furrysalamander/Pi-A3-Game-Console/README.md

# Pi-A3-Game-Console

The firmware for the microcontroller that handles the inputs is in the controller folder.
