furrysalamander/Pi-A3-Game-Console/Pi-A3-Game-Console/Game-Console-Finish-Schematic.pdf

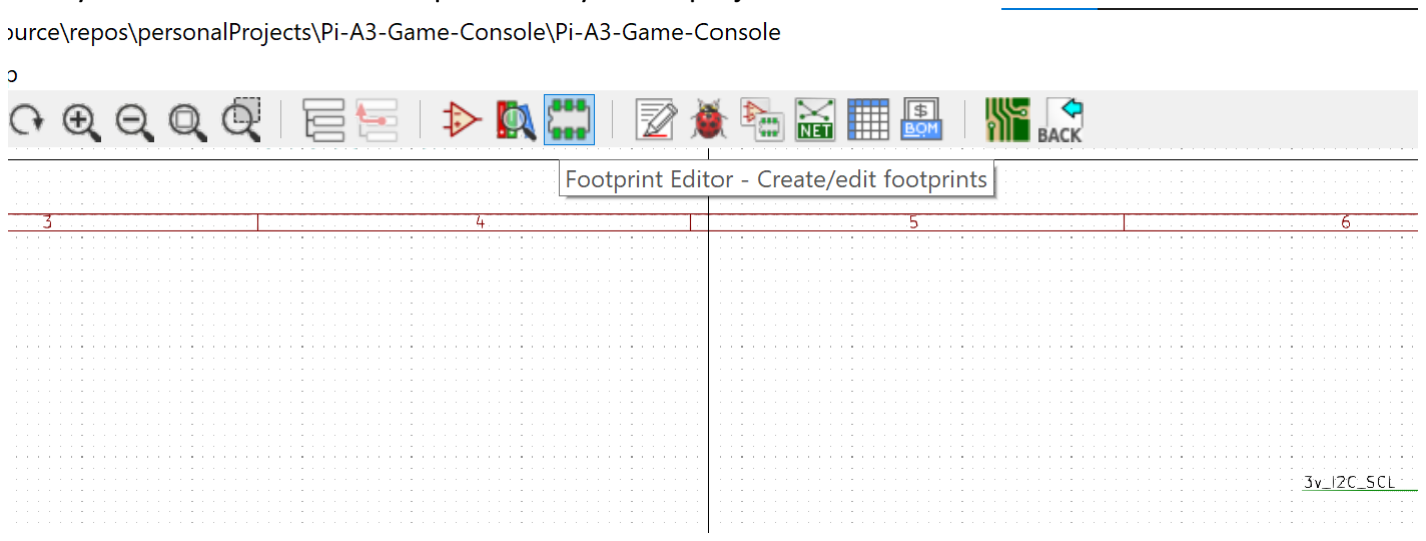
[picture p1: figure]

First you’ll need to add the footprint library to the project

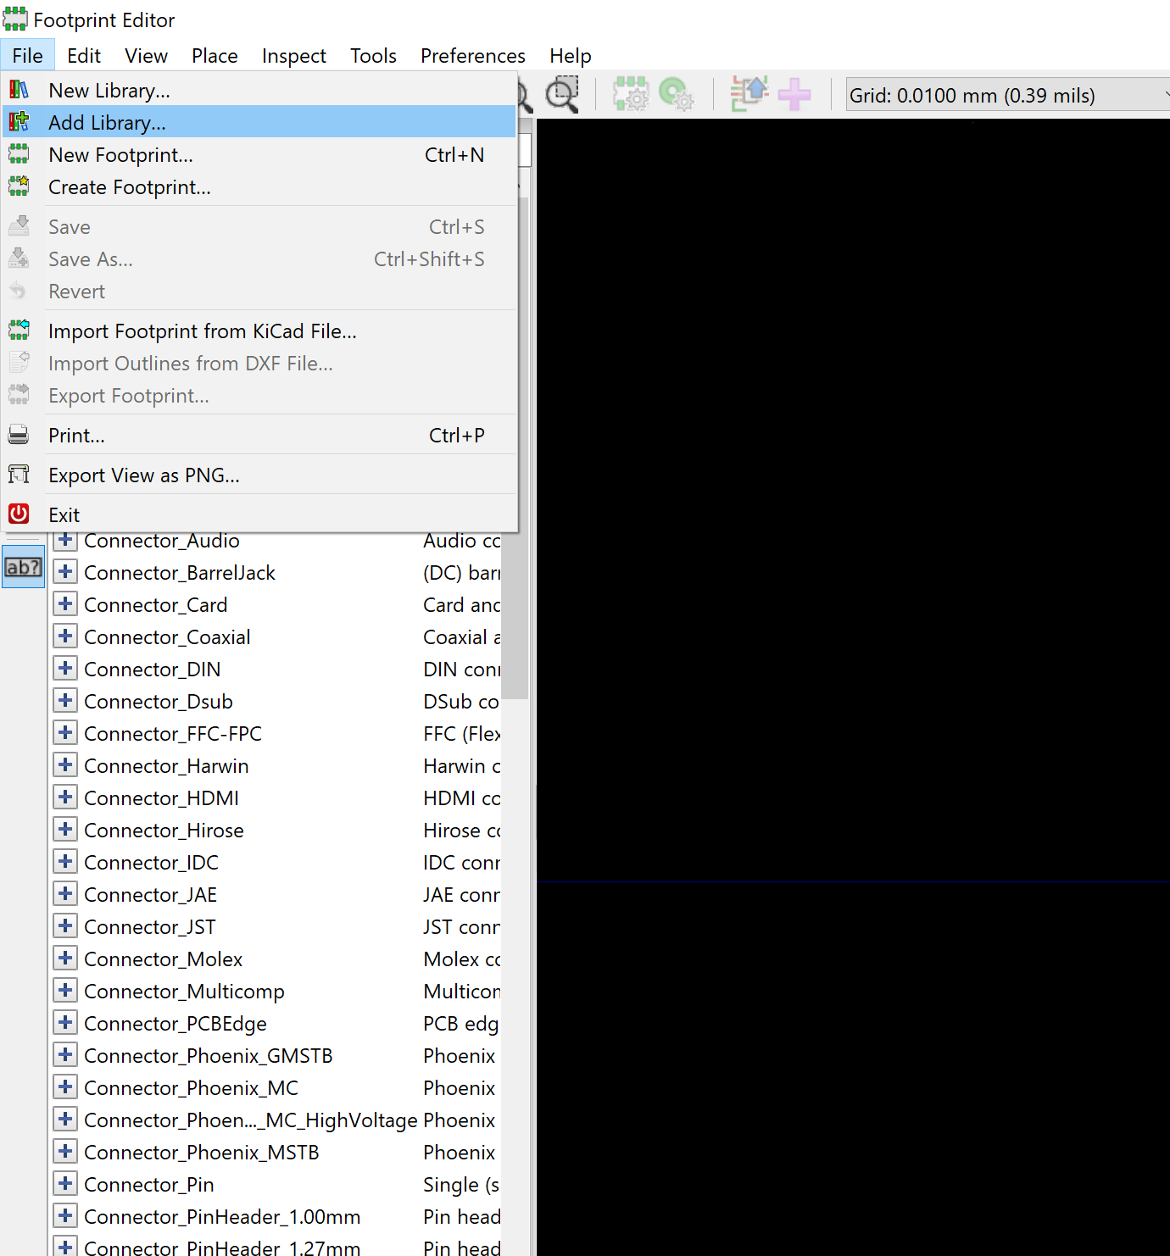
[picture p2: figure]
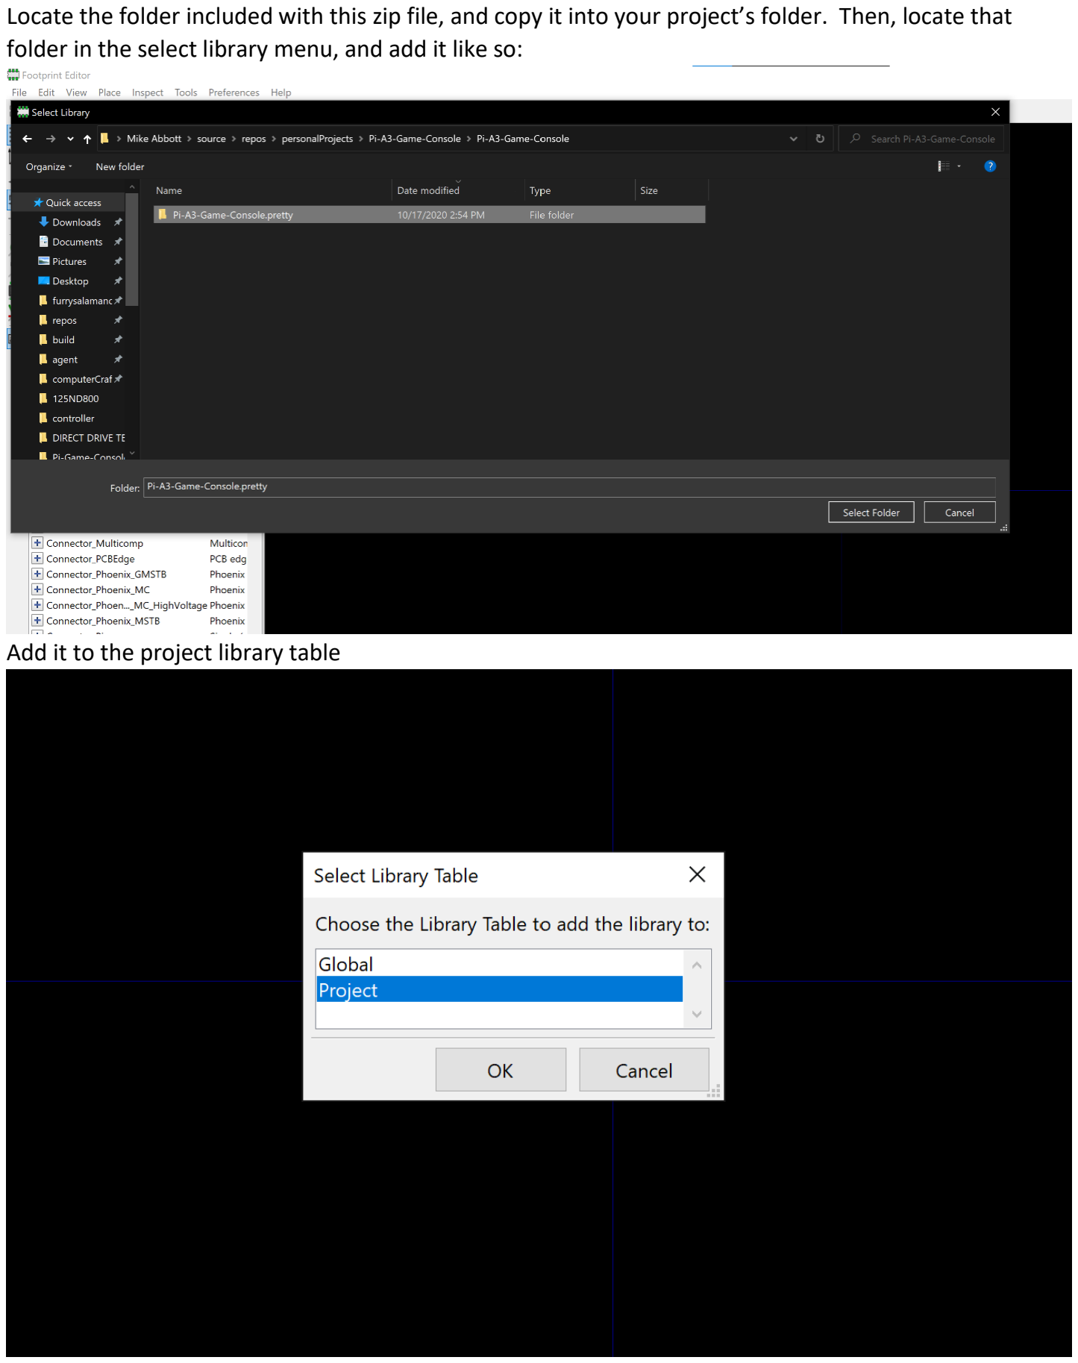
[picture p3: page 3]

Locate the folder included with this zip file, and copy it into your project’s folder. Then, locate that folder in the select library menu, and add it like so:

Add it to the project library table

Verify that it was successfully added by searching for it in the footprint editor. If it’s there, you can close this window and proceed to the next step.

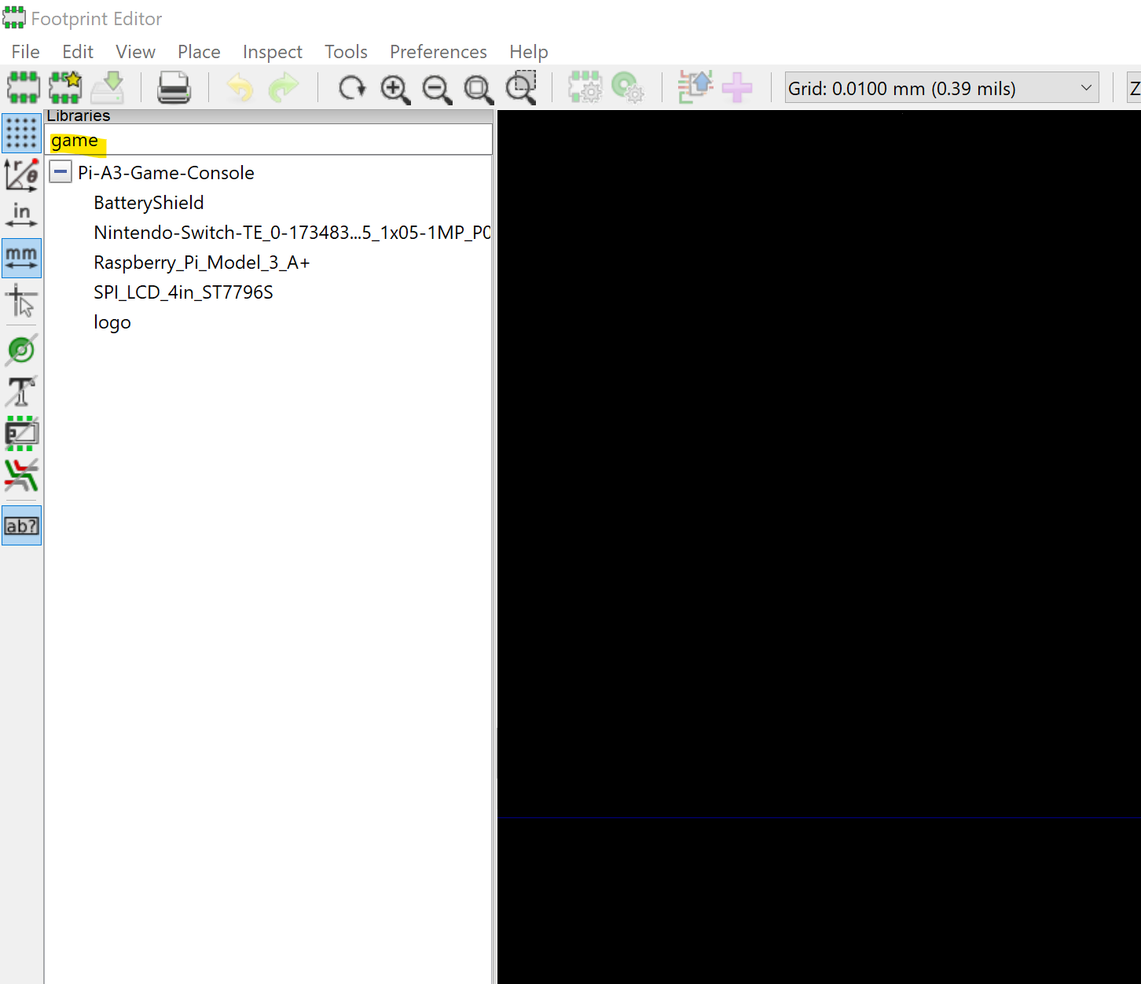
[picture p4: figure]

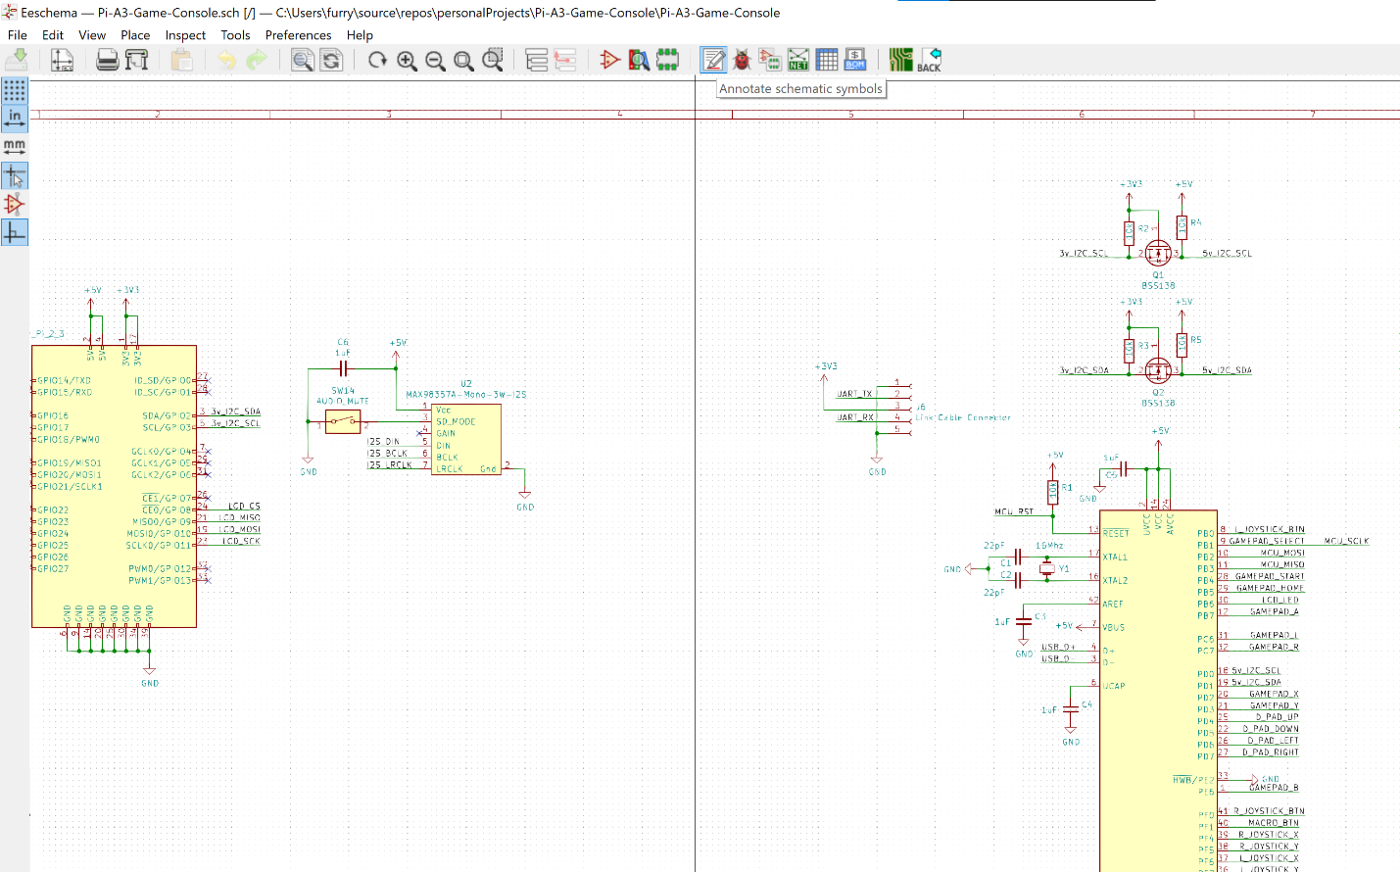
[picture p5: figure]

Next you’ll need to assign part numbers to each component. Do this using this button.

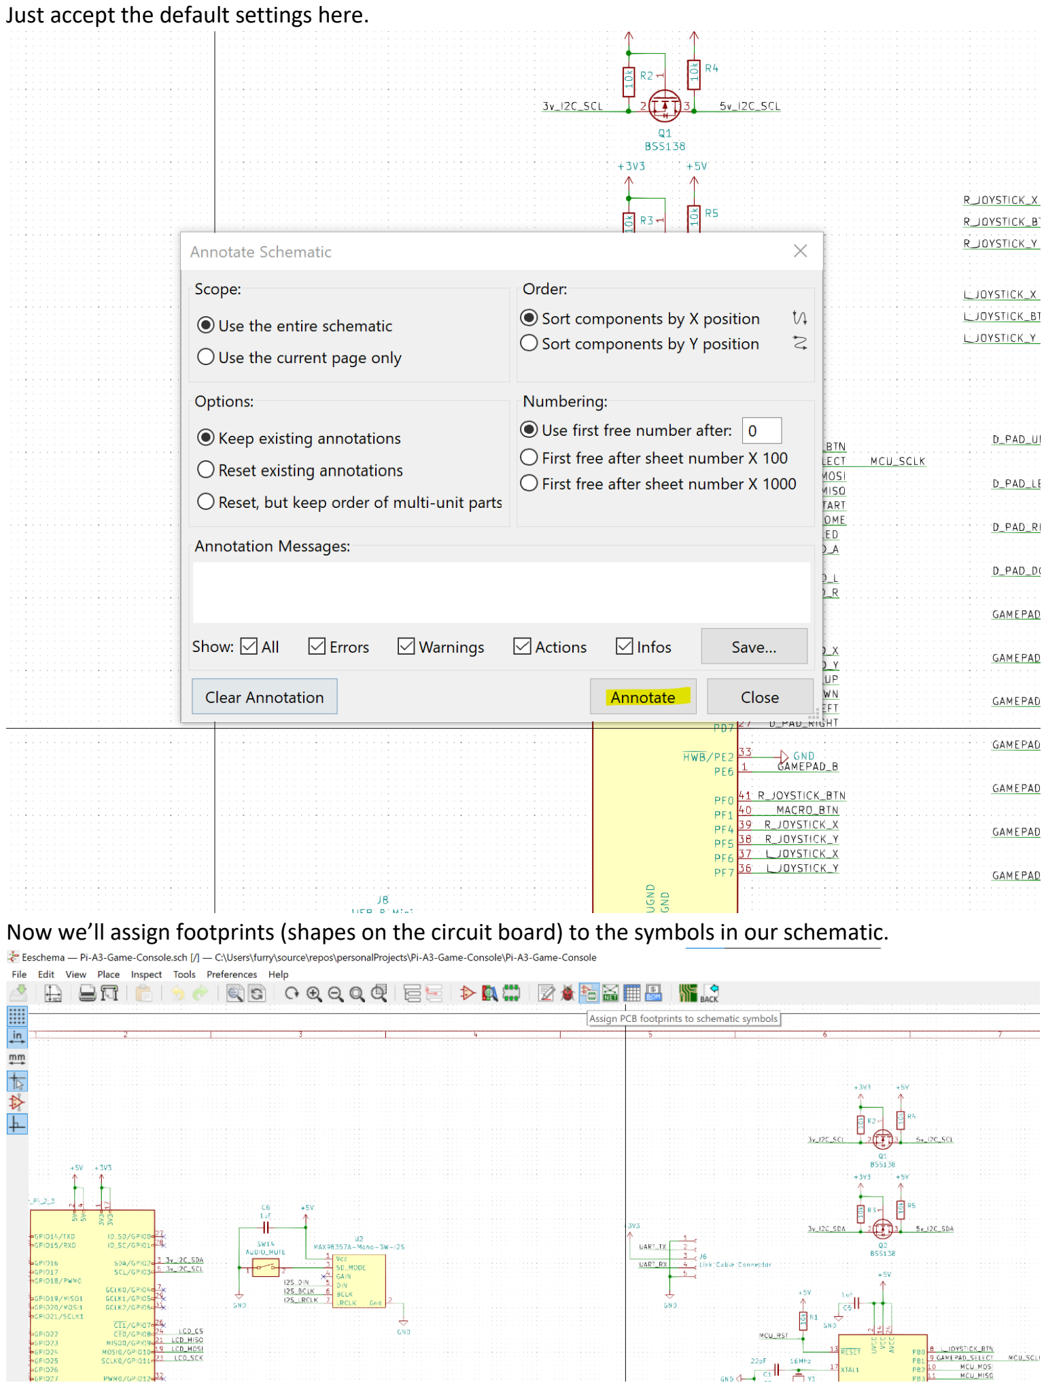
[picture p6: page 6]

Just accept the default settings here.

Now we’ll assign footprints (shapes on the circuit board) to the symbols in our schematic.

This part is a little tricky, so I’m going to suggest the easiest way to do it. First, select the top
component. Then, uncheck all three of those boxes on the left hand side of label 2. This may cause your computer to lag for a second. Then make sure the box right next to the search bar is checked. Then you can just search for the footprint names. Once you’ve found the matching footprint, go ahead and double click it over on the right side. That will assign that footprint to that symbol. Go through and assign footprints to each schematic symbol. You’ll need to match them based on the value of each part, IE, 22pF, and *NOT* the symbol number (IE, C1) because it may be different on your project.

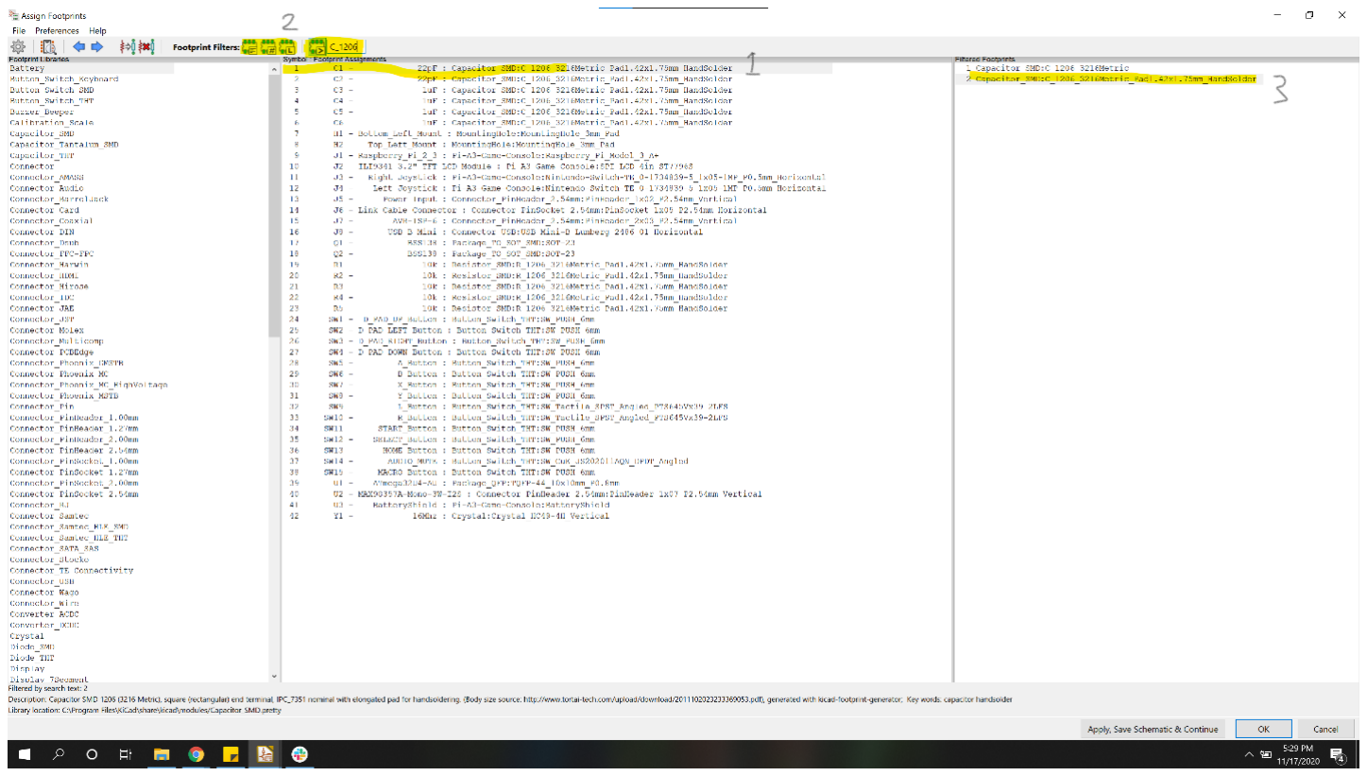
[picture p7: figure]
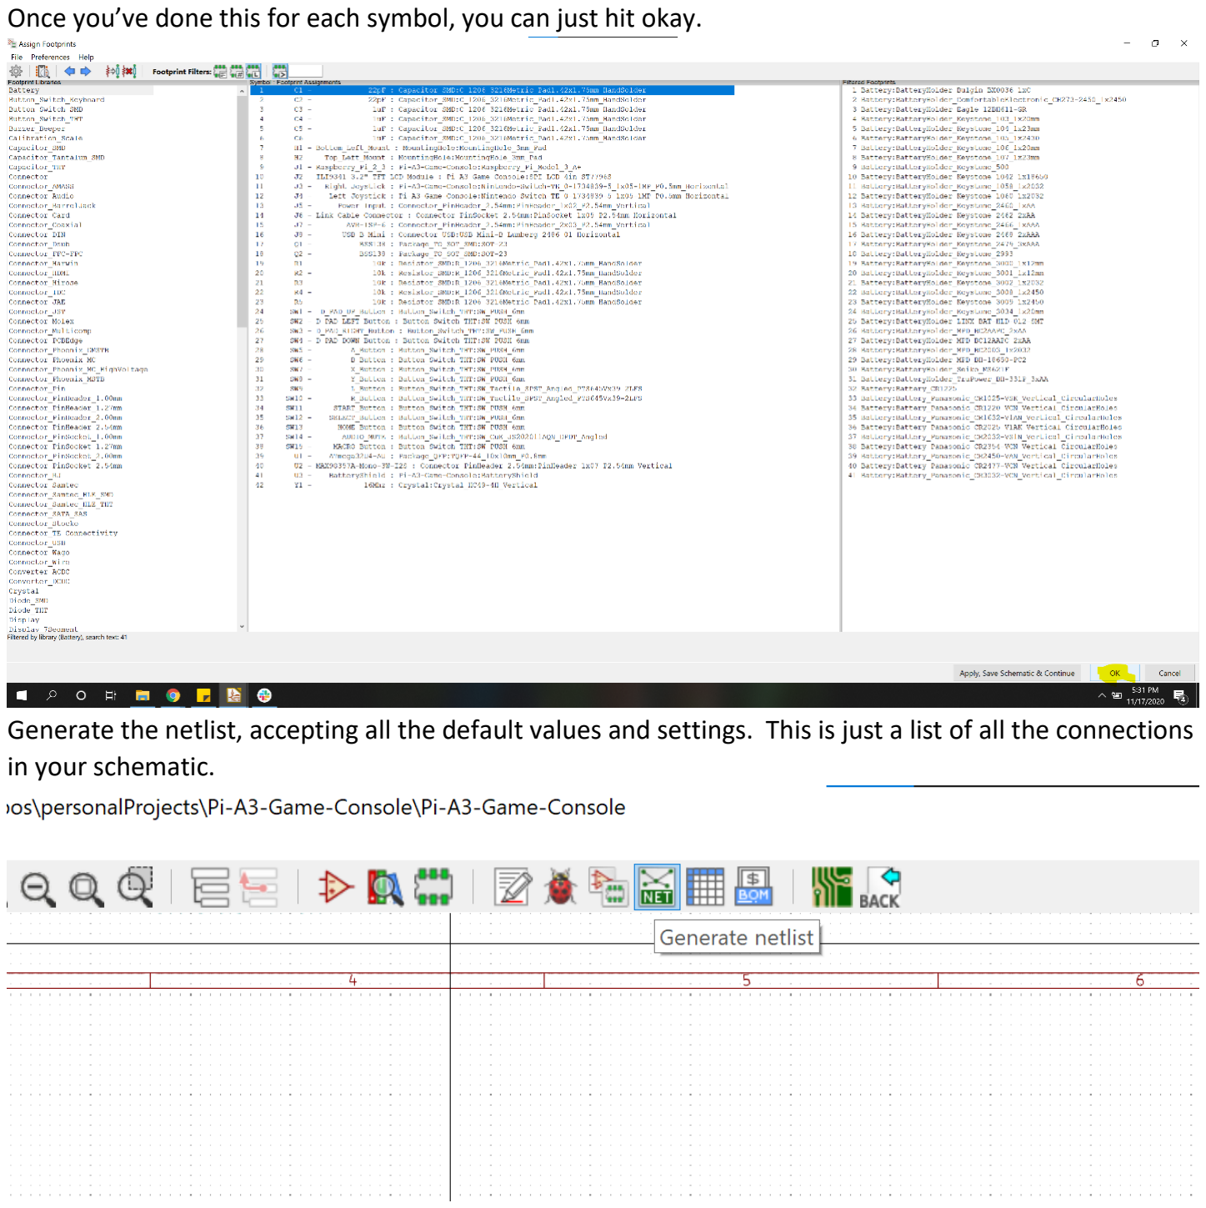
[picture p8: page 8]

Once you’ve done this for each symbol, you can just hit okay.

Generate the netlist, accepting all the default values and settings. This is just a list of all the connections in your schematic.

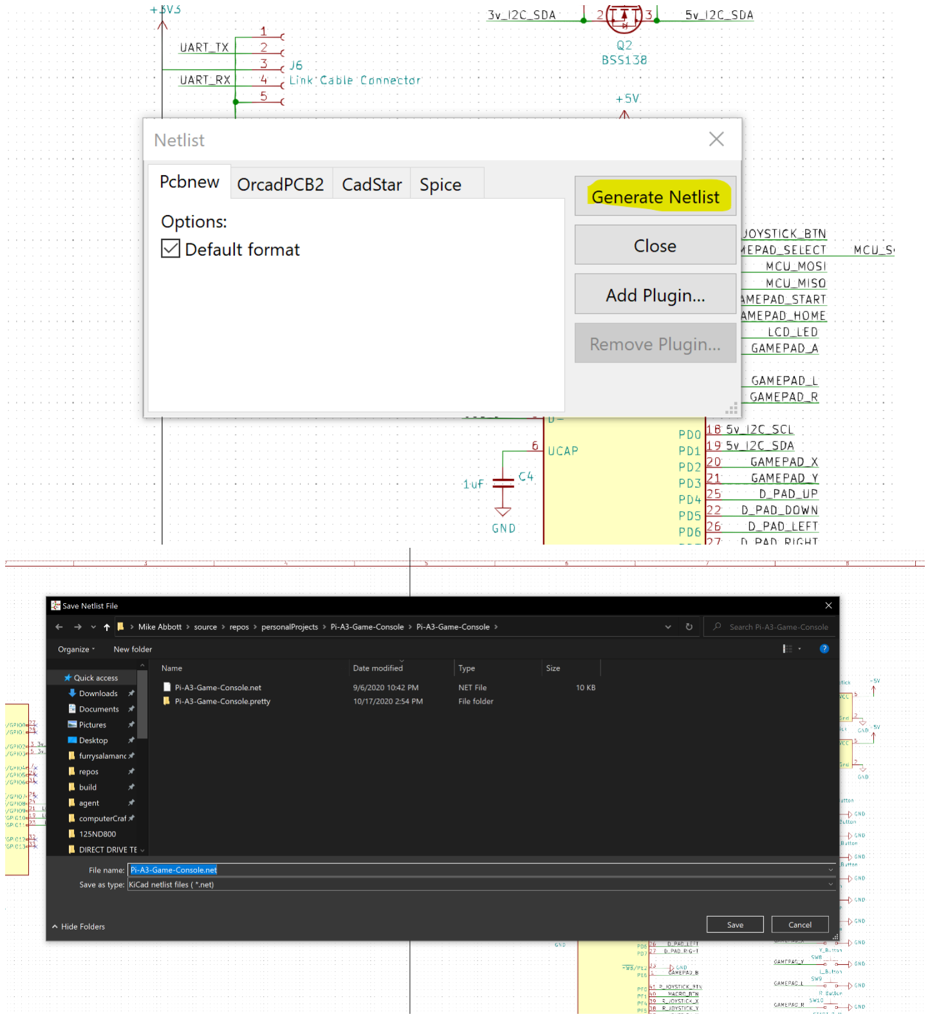
[picture p9: figure]
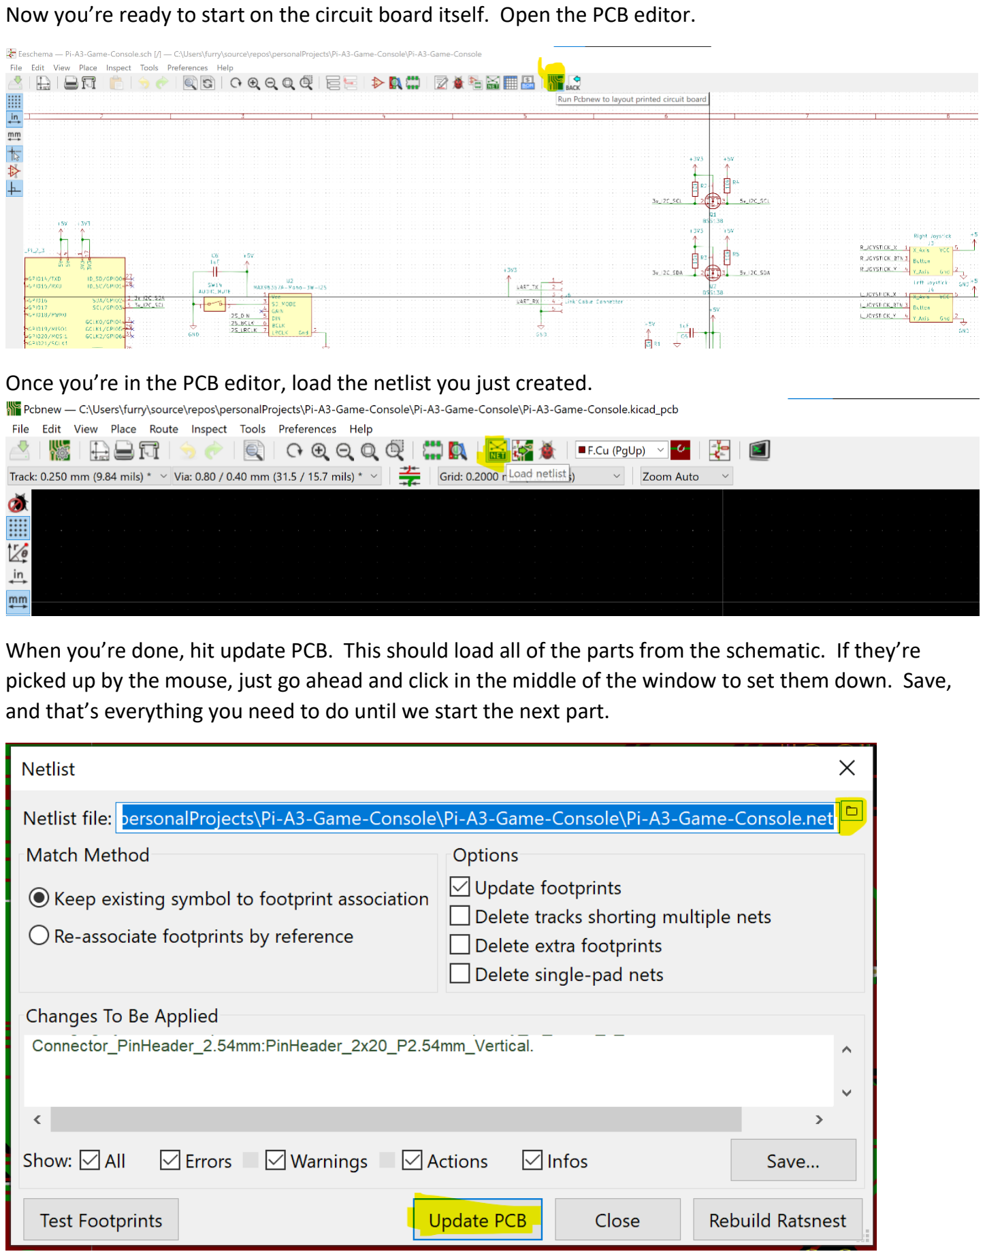
[picture p10: page 10]

Now you’re ready to start on the circuit board itself. Open the PCB editor.

Once you’re in the PCB editor, load the netlist you just created.

When you’re done, hit update PCB. This should load all of the parts from the schematic. If they’re picked up by the mouse, just go ahead and click in the middle of the window to set them down. Save, and that’s everything you need to do until we start the next part.
