furrysalamander/Pi-A3-Game-Console/GameConsoleCase/Small Button.stl

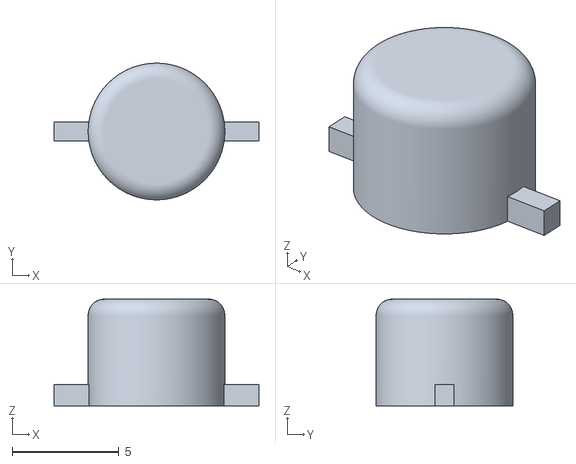
[picture p11: CAD file, 2021-10-13]
GameConsoleCase/Small Button.stl
9.60 x 6.40 x 5.00
