furrysalamander/Pi-A3-Game-Console/Pi-A3-Game-Console/4-LCD-Rough-v2.step

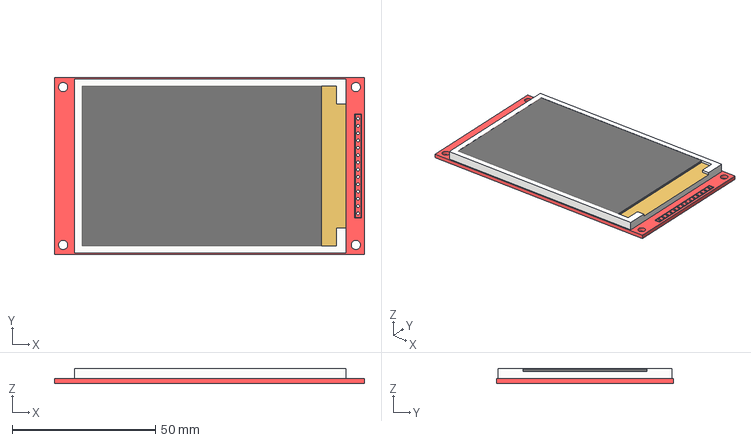
[picture p12: CAD file, 2020-10-09]
Pi-A3-Game-Console/4-LCD-Rough-v2.step
108.0 x 61.7 x 5.10 mm
