furrysalamander/Pi-A3-Game-Console/GameConsoleCase/Battery Panel.stl

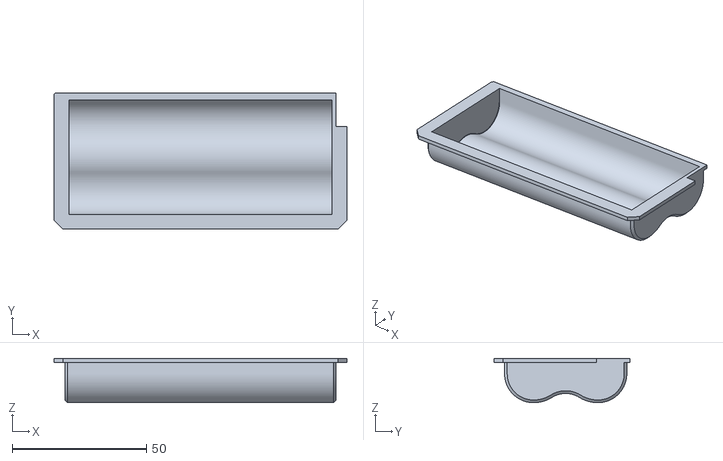
[picture p13: CAD file, 2021-10-13]
GameConsoleCase/Battery Panel.stl
109.0 x 50.8 x 16.5
