furrysalamander/Pi-A3-Game-Console/Pi-A3-Game-Console/Battery Shield.step

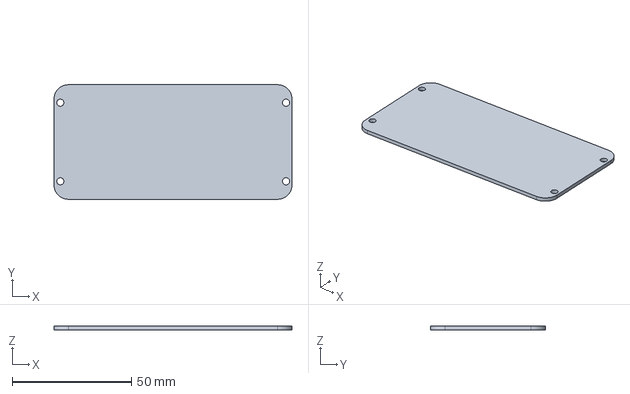
[picture p14: CAD file, 2020-10-09]
Pi-A3-Game-Console/Battery Shield.step
100.0 x 48.1 x 1.60 mm
