furrysalamander/Pi-A3-Game-Console/GameConsoleCase/Rear Panel.stl

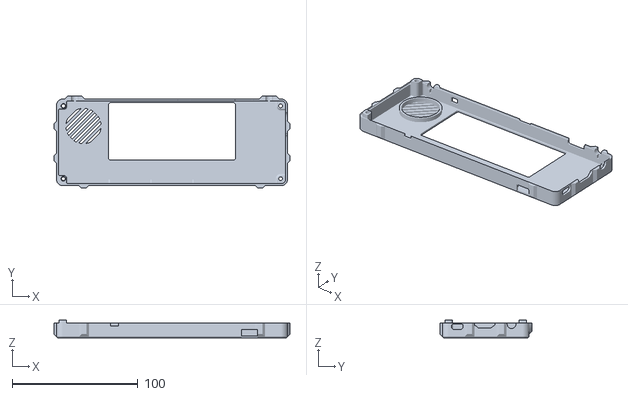
[picture p15: CAD file, 2021-10-13]
GameConsoleCase/Rear Panel.stl
188.0 x 73.5 x 14.3
