furrysalamander/Pi-A3-Game-Console/Pi-A3-Game-Console/LCD_Rough.dxf

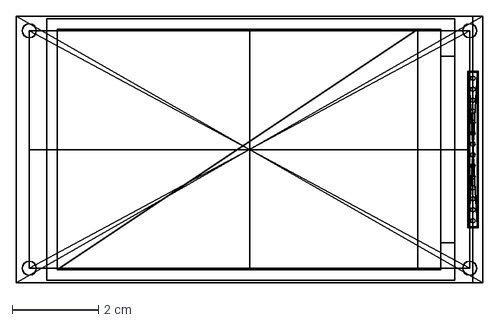
[picture p16: CAD file, 2020-10-09]
Pi-A3-Game-Console/LCD_Rough.dxf
10.8 x 6.17 cm
