furrysalamander/Pi-A3-Game-Console/GameConsoleCase/dpad.stl

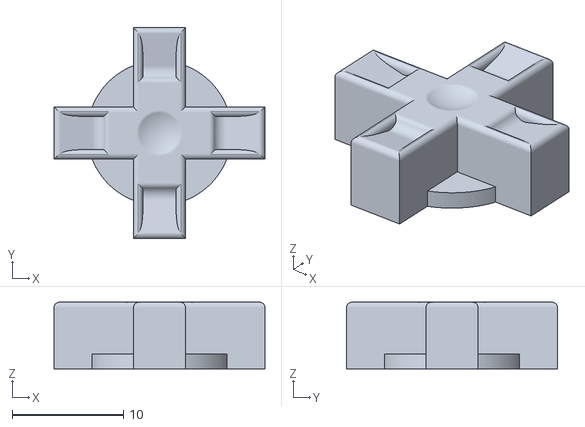
[picture p17: CAD file, 2021-10-13]
GameConsoleCase/dpad.stl
19.0 x 19.0 x 6.00
