furrysalamander/Pi-A3-Game-Console/GameConsoleCase/Front Panel.stl

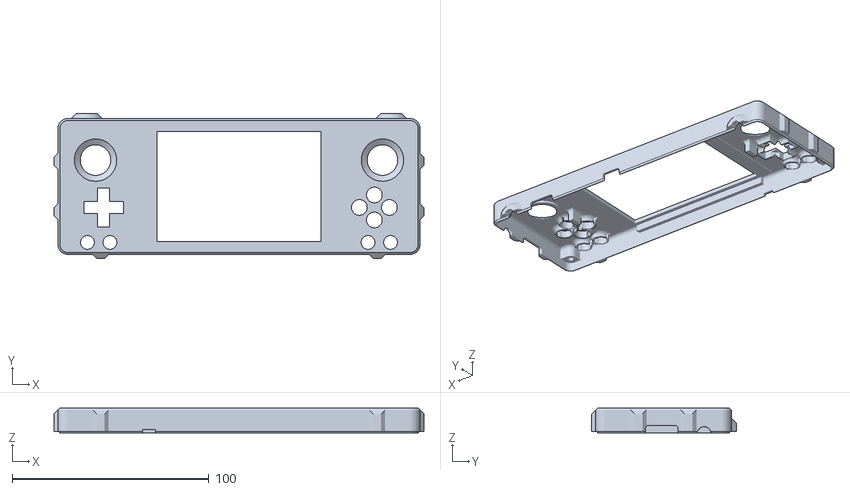
[picture p18: CAD file, 2021-10-13]
GameConsoleCase/Front Panel.stl
188.0 x 73.5 x 12.7
