furrysalamander/Pi-A3-Game-Console/Pi-A3-Game-Console/Pi-A-Mechanical.dxf

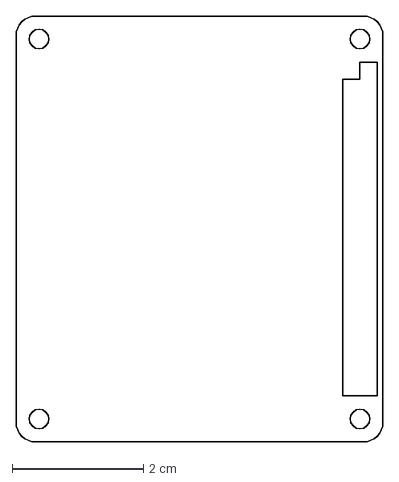
[picture p19: CAD file, 2020-09-22]
Pi-A3-Game-Console/Pi-A-Mechanical.dxf
5.60 x 6.50 cm
