furrysalamander/Pi-A3-Game-Console/GameConsoleCase/Button.stl

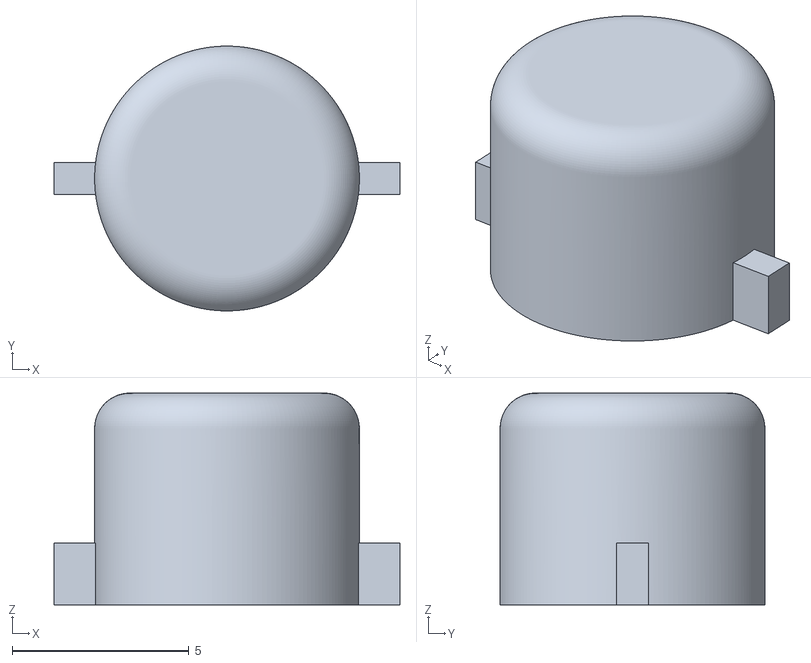
[picture p20: CAD file, 2021-10-13]
GameConsoleCase/Button.stl
9.80 x 7.50 x 6.00
