furrysalamander/Pi-A3-Game-Console/Pi-A3-Game-Console/switch_joystick.step

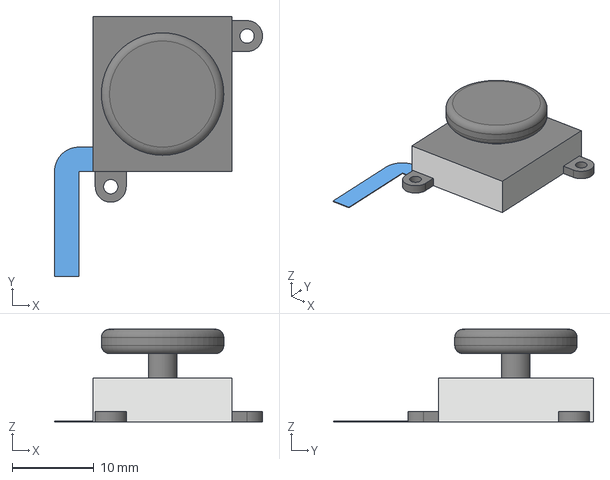
[picture p21: CAD file, 2020-09-22]
Pi-A3-Game-Console/switch_joystick.step
25.5 x 31.9 x 11.3 mm
