furrysalamander/Pi-A3-Game-Console/GameConsoleCase/Shoulder Button.stl

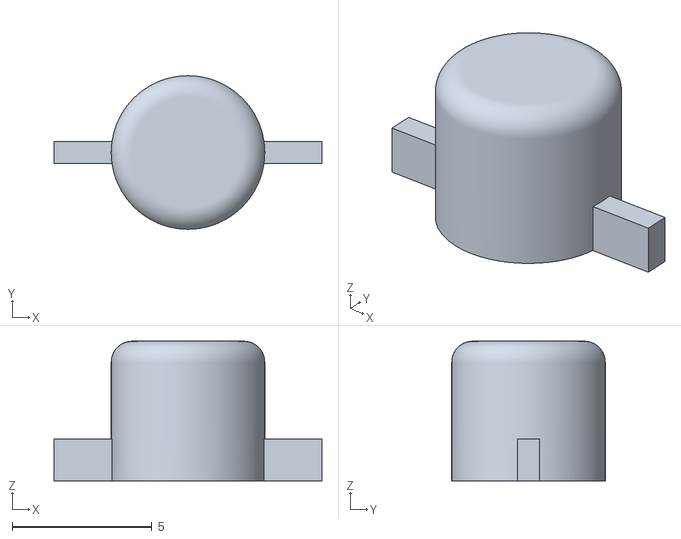
[picture p22: CAD file, 2021-10-13]
GameConsoleCase/Shoulder Button.stl
9.60 x 5.50 x 5.00
