furrysalamander/Pi-A3-Game-Console/Pi-A3-Game-Console/ssfv5r_4stlf.stp

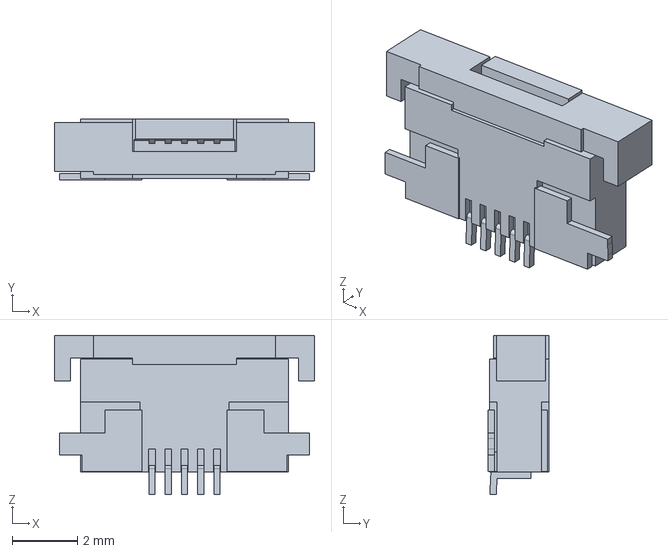
[picture p23: CAD file, 2020-09-22]
Pi-A3-Game-Console/ssfv5r_4stlf.stp
8.00 x 1.87 x 4.90 mm
