furrysalamander/Pi-A3-Game-Console/Pi-A3-Game-Console/switch_joystick_outline.dxf

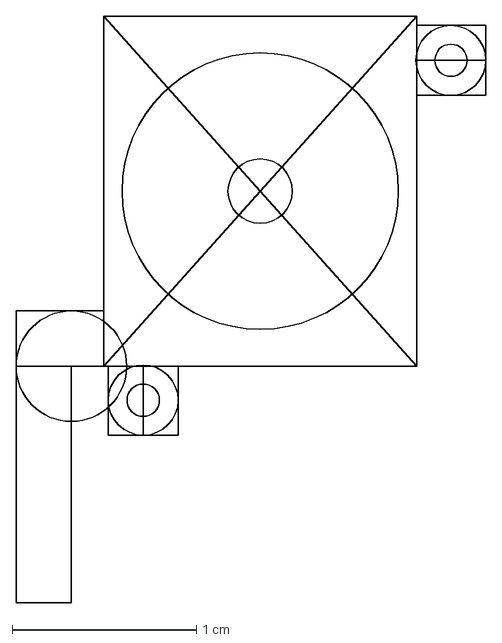
[picture p24: CAD file, 2020-09-22]
Pi-A3-Game-Console/switch_joystick_outline.dxf
2.55 x 3.18 cm
