furrysalamander/Pi-A3-Game-Console/Pi-A3-Game-Console/5051100592.stp

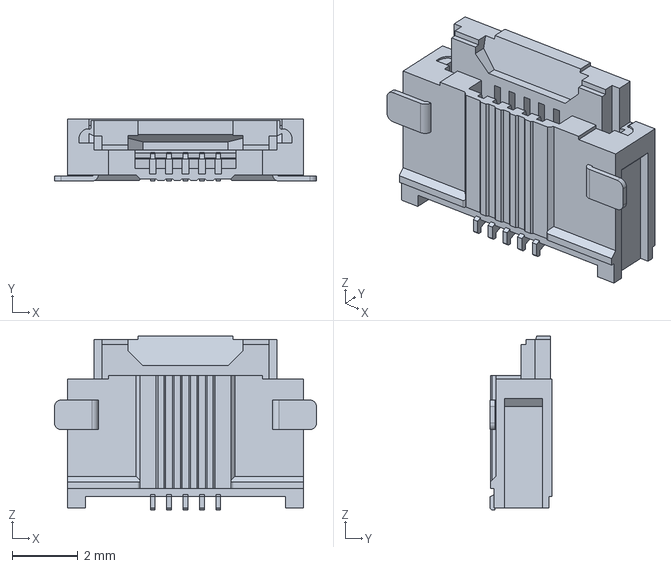
[picture p25: CAD file, 2020-09-22]
Pi-A3-Game-Console/5051100592.stp
8.00 x 1.90 x 5.30 mm
