furrysalamander/Pi-A3-Game-Console/Pi-A3-Game-Console/18650.step

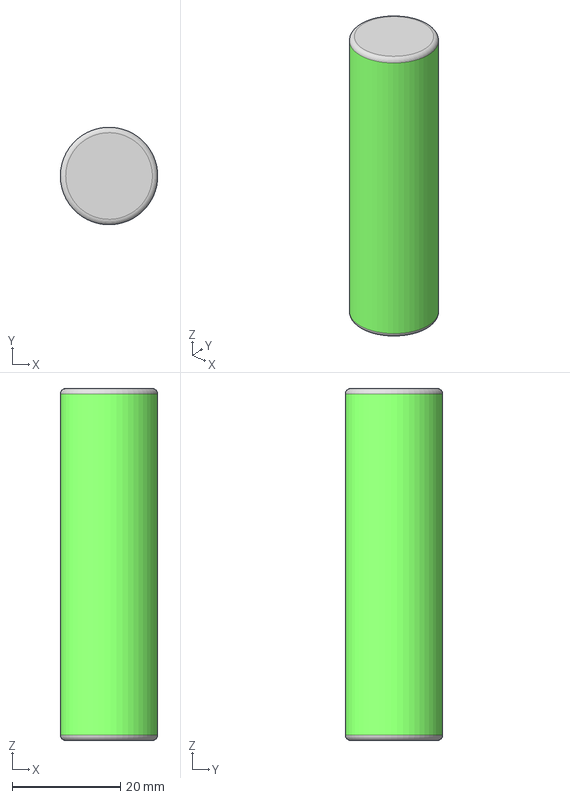
[picture p26: CAD file, 2020-09-22]
Pi-A3-Game-Console/18650.step
18.0 x 18.0 x 65.0 mm
