furrysalamander/Pi-A3-Game-Console/(list of files, cad)

Other CAD files:
Pi-A3-Game-Console/Battery_Shield.dxf
