furrysalamander/Pi-A3-Game-Console/Schematic.pdf

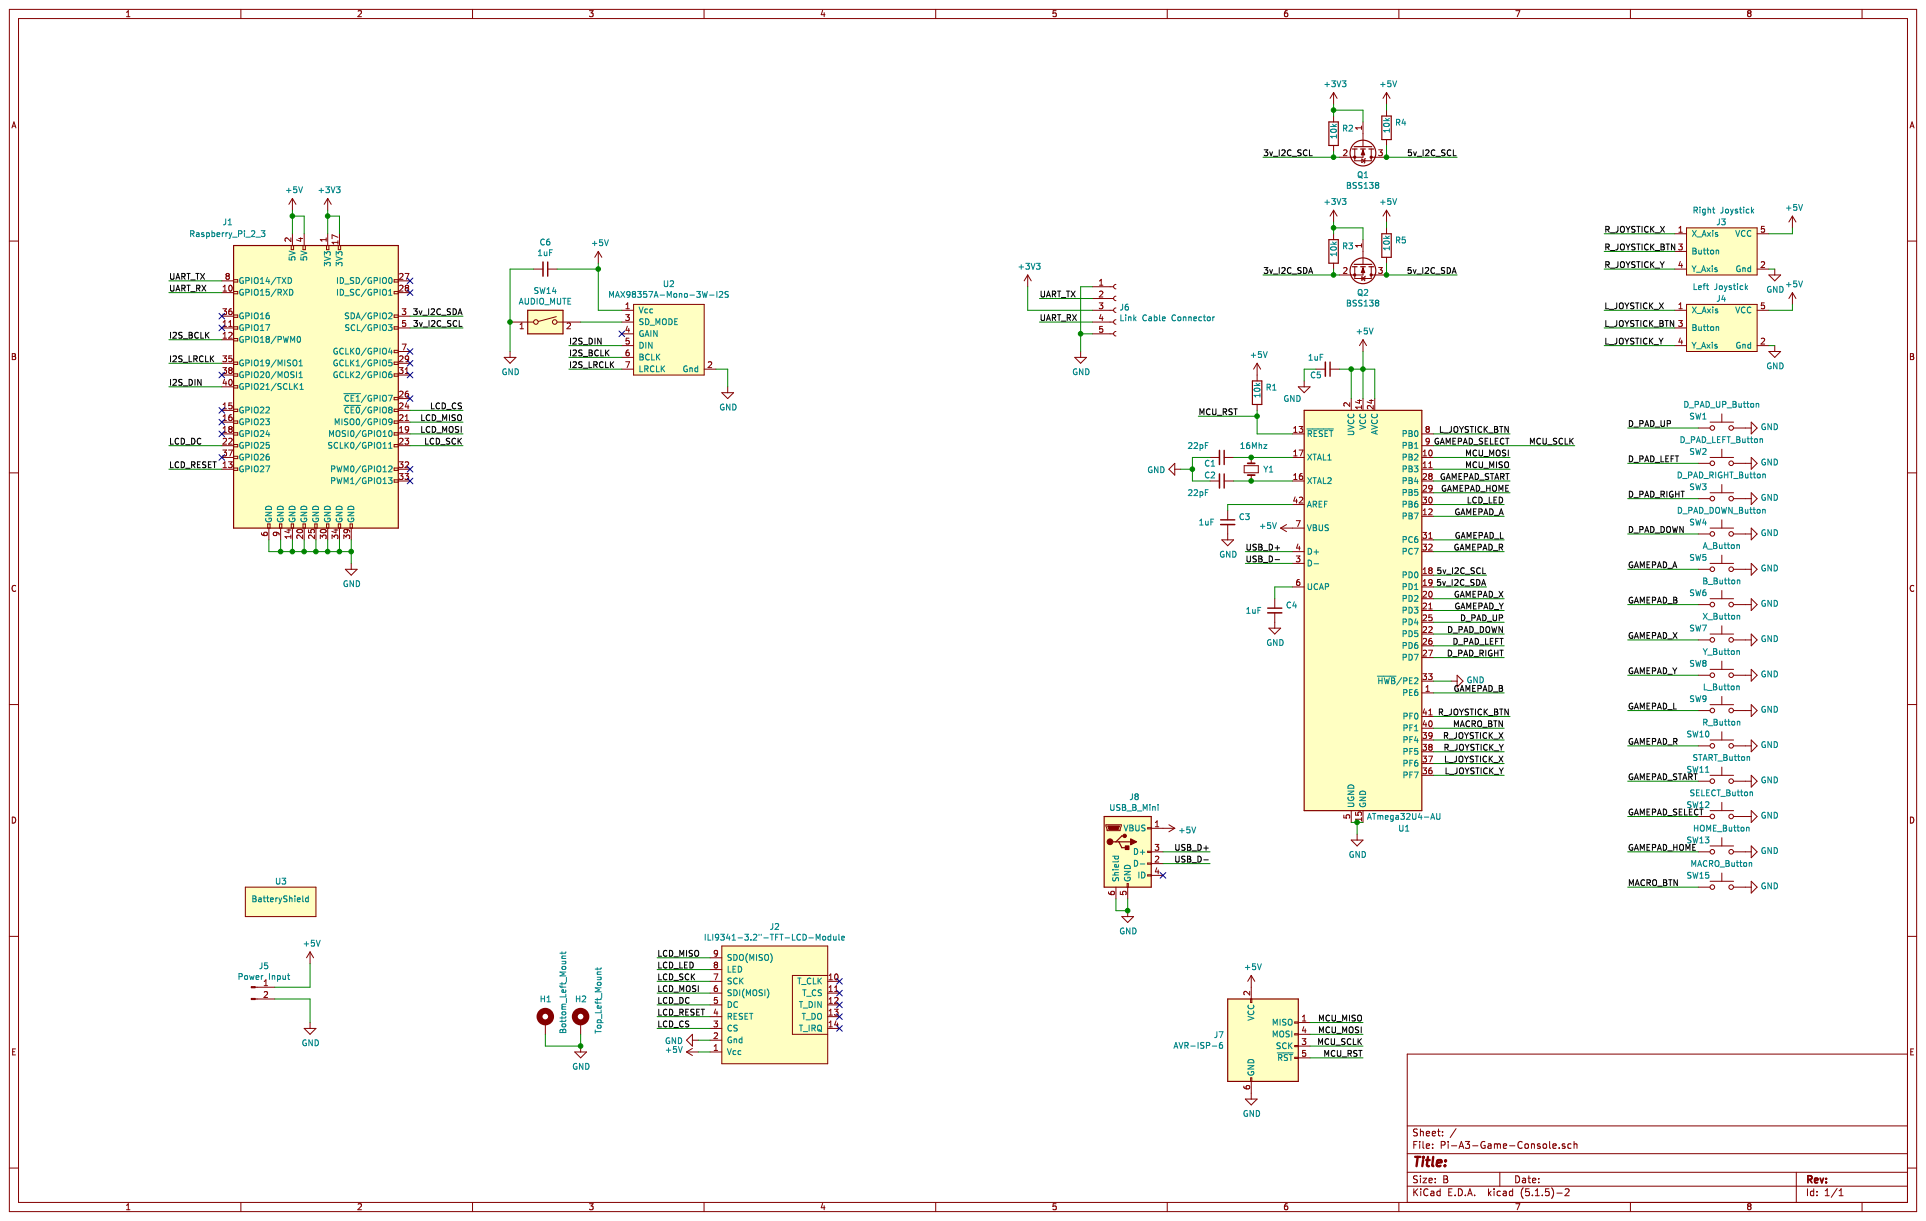
[picture p27: page 1]
