furrysalamander/Pi-A3-Game-Console/test.pdf

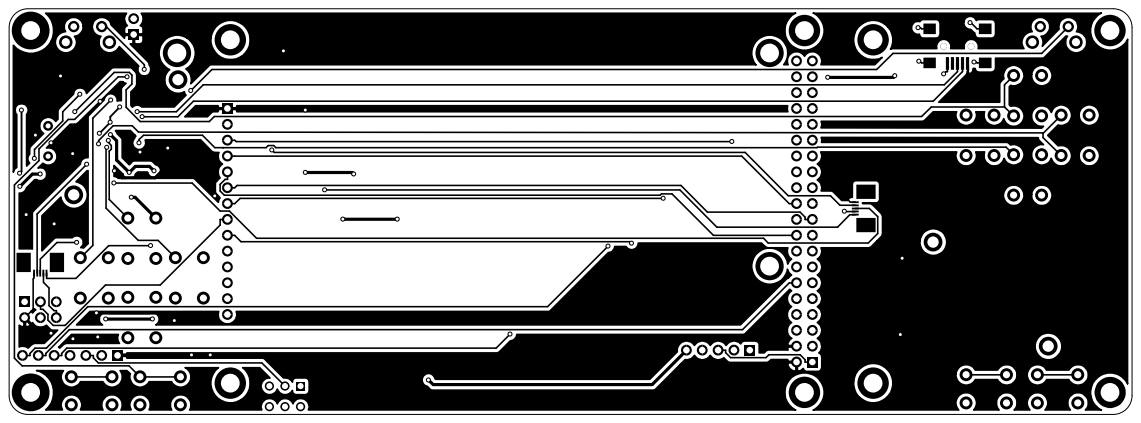
[picture p28: page 1]
