furrysalamander/Pi-A3-Game-Console/(list of files, drawings)

Other design files:
Pi-A3-Game-Console.dsn
