furrysalamander/Pi-A3-Game-Console/Pi-A3-Game-Console/Pi-A3-Game-Console.sch

## KiCad design Pi-A3-Game-Console/Pi-A3-Game-Console.sch (2020-10-16)

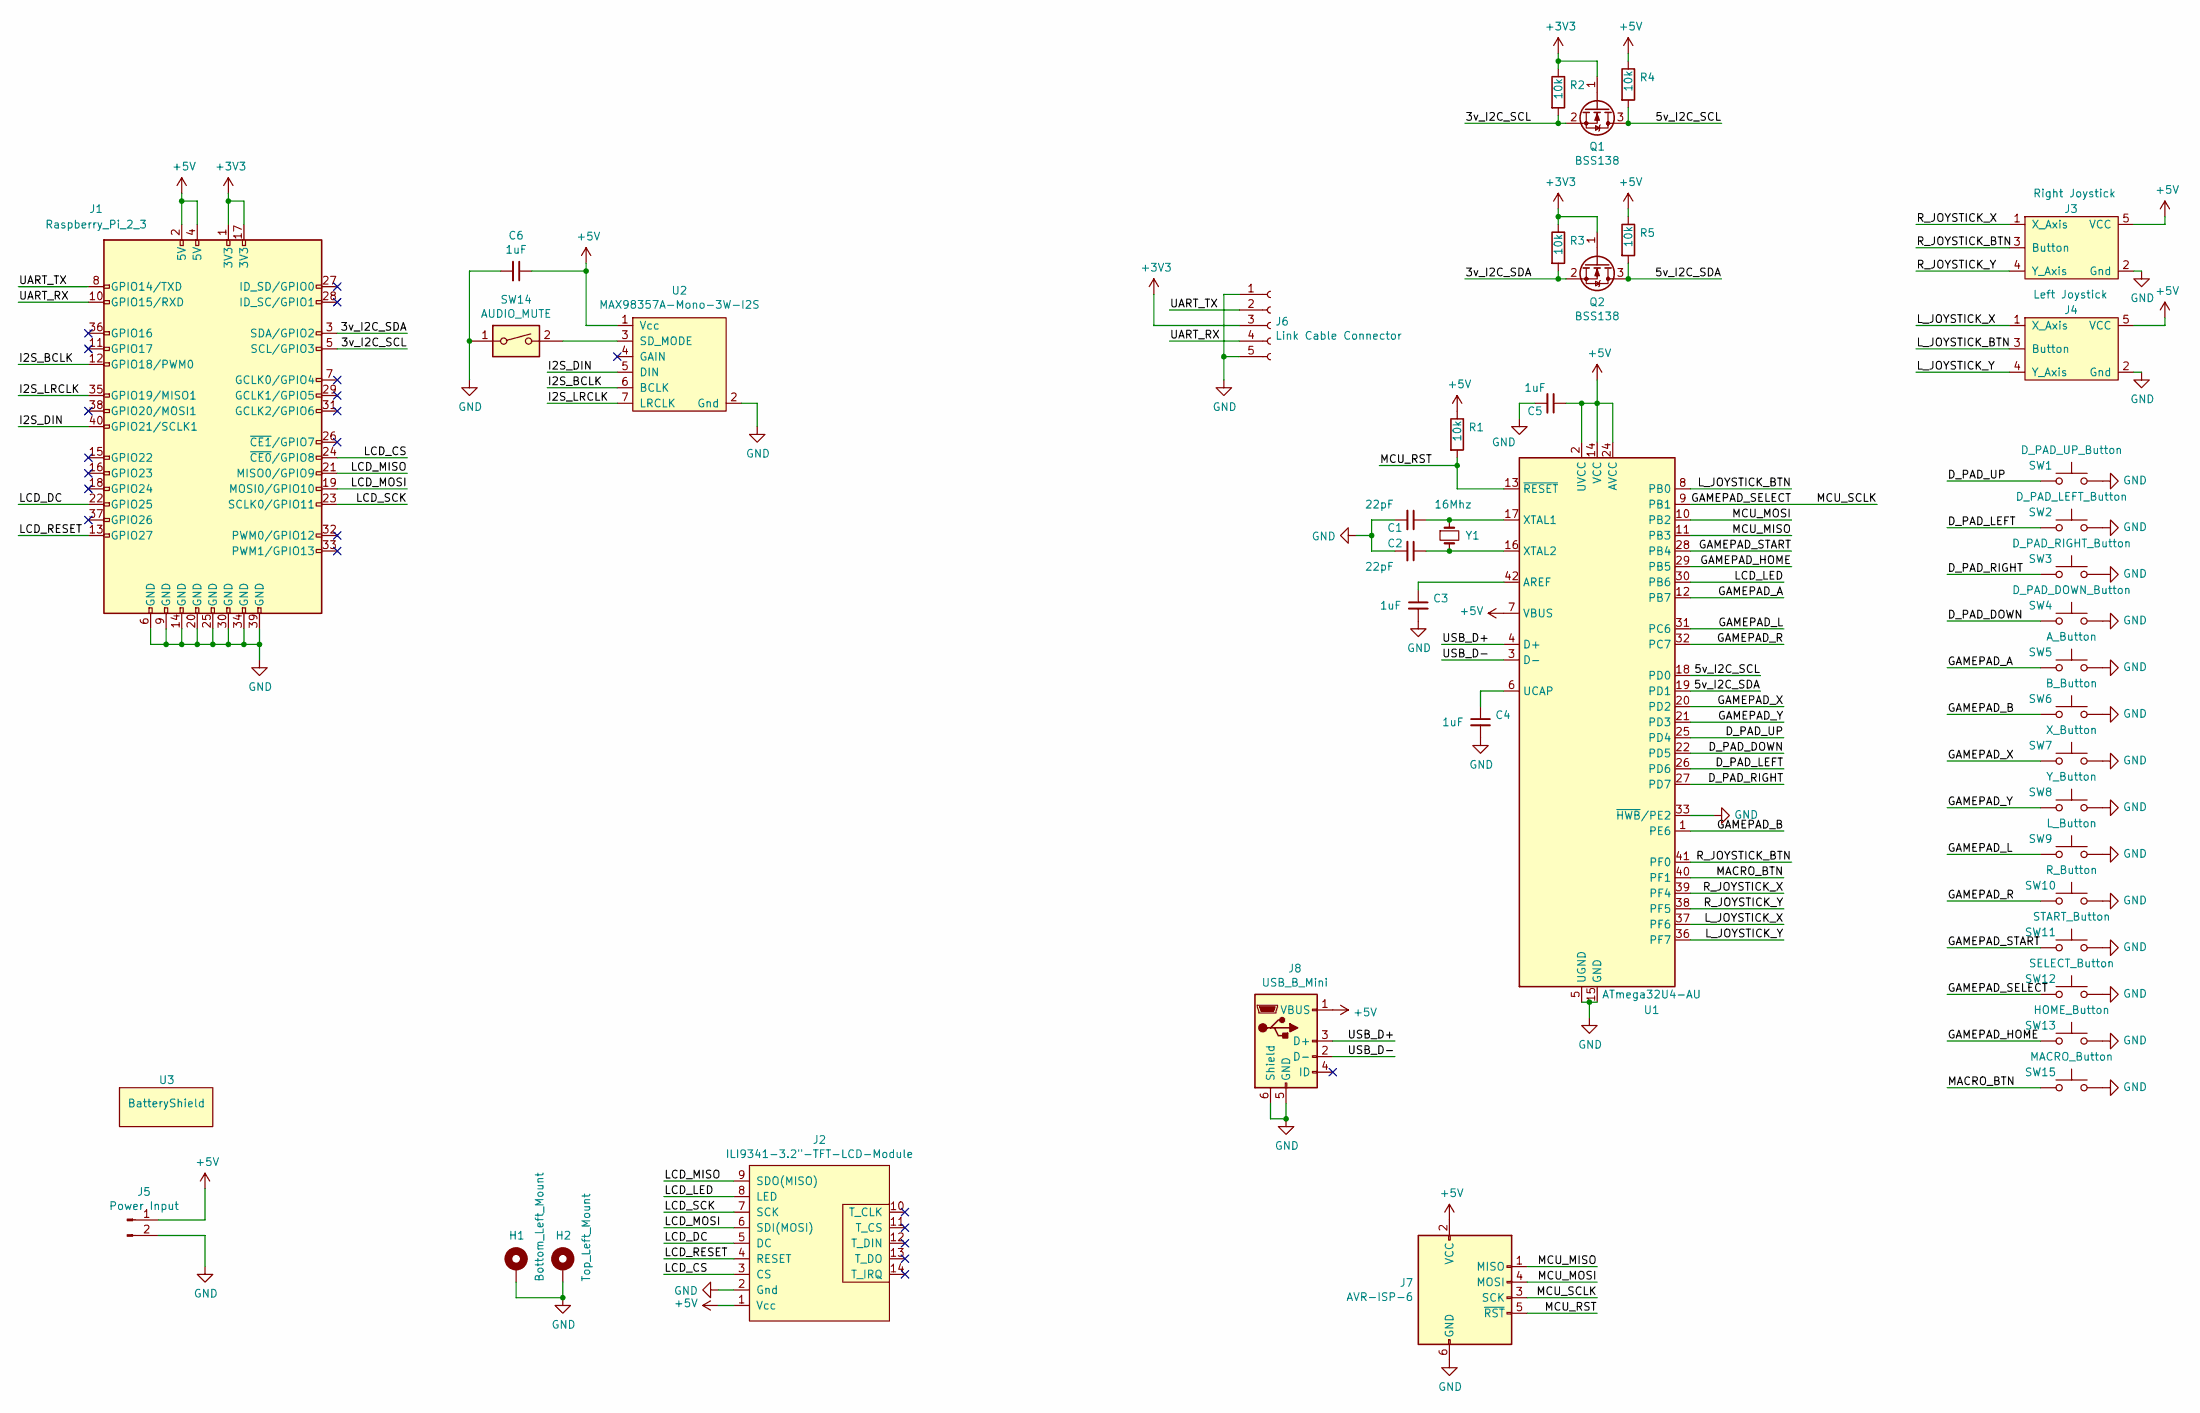
[picture p29: schematic Pi-A3-Game-Console.sch]

Parts:
C1, C2: 22pF; C_1206_3216Metric_Pad1.42x1.75mm_HandSolder
C3, C4, C5, C6: 1uF; C_1206_3216Metric_Pad1.42x1.75mm_HandSolder
H1: Bottom_Left_Mount; MountingHole_3mm_Pad
H2: Top_Left_Mount; MountingHole_3mm_Pad
J1: Raspberry_Pi_2_3; Raspberry_Pi_Model_3_A+
J2: ILI9341-3.2\"-TFT-LCD-Module; SPI_LCD_4in_ST7796S
J3: Right Joystick; Nintendo-Switch-TE_0-1734839-5_1x05-1MP_P0.5mm_Horizontal
J4: Left Joystick; Nintendo-Switch-TE_0-1734839-5_1x05-1MP_P0.5mm_Horizontal
J5: Power Input; PinHeader_1x02_P2.54mm_Vertical
J6: Link Cable Connector; PinSocket_1x05_P2.54mm_Horizontal
J7: AVR-ISP-6; PinHeader_2x03_P2.54mm_Vertical
J8: USB_B_Mini; USB_Mini-B_Lumberg_2486_01_Horizontal
Q1, Q2: BSS138; SOT-23
R1, R2, R3, R4, R5: 10k; R_1206_3216Metric_Pad1.42x1.75mm_HandSolder
SW1: D_PAD_UP_Button; SW_PUSH_6mm
SW2: D_PAD_LEFT_Button; SW_PUSH_6mm
SW3: D_PAD_RIGHT_Button; SW_PUSH_6mm
SW4: D_PAD_DOWN_Button; SW_PUSH_6mm
SW5: A_Button; SW_PUSH_6mm
SW6: B_Button; SW_PUSH_6mm
SW7: X_Button; SW_PUSH_6mm
SW8: Y_Button; SW_PUSH_6mm
SW9: L_Button; SW_Tactile_SPST_Angled_PTS645Vx39-2LFS
SW10: R_Button; SW_Tactile_SPST_Angled_PTS645Vx39-2LFS
SW11: START_Button; SW_PUSH_6mm
SW12: SELECT_Button; SW_PUSH_6mm
SW13: HOME_Button; SW_PUSH_6mm
SW14: AUDIO_MUTE; SW_CuK_JS202011AQN_DPDT_Angled
SW15: MACRO_Button; SW_PUSH_6mm
U1: ATmega32U4-AU; TQFP-44_10x10mm_P0.8mm
U2: MAX98357A-Mono-3W-I2S; PinHeader_1x07_P2.54mm_Vertical
U3: BatteryShield
Y1: 16Mhz; Crystal_HC49-4H_Vertical

Connections:
3v_I2C_SCL: J1.5 (SCL/GPIO3), Q1.2 (S), R2.2
3v_I2C_SDA: J1.3 (SDA/GPIO2), Q2.2 (S), R3.2
5v_I2C_SCL: Q1.3 (D), R4.2, U1.18 (PD0)
5v_I2C_SDA: Q2.3 (D), R5.2, U1.19 (PD1)
+3V3: J1.1 (3V3), J1.17 (3V3), J6.3, Q1.1 (G), Q2.1 (G), R2.1, R3.1
+5V: C5.1, C6.1, J1.2 (5V), J1.4 (5V), J2.1 (Vcc), J3.5 (VCC), J4.5 (VCC), J5.1, J7.2 (VCC), J8.1 (VBUS), R1.1, R4.1, R5.1, U1.2 (UVCC), U1.7 (VBUS), U1.14 (VCC), U1.24 (AVCC), U1.34 (VCC), U1.44 (AVCC), U2.1 (Vcc)
D_PAD_DOWN: SW4.1, U1.22 (PD5)
D_PAD_LEFT: SW2.1, U1.26 (PD6)
D_PAD_RIGHT: SW3.1, U1.27 (PD7)
D_PAD_UP: SW1.1, U1.25 (PD4)
GAMEPAD_A: SW5.1, U1.12 (PB7)
GAMEPAD_B: SW6.1, U1.1 (PE6)
GAMEPAD_HOME: SW13.1, U1.29 (PB5)
GAMEPAD_L: SW9.1, U1.31 (PC6)
GAMEPAD_R: SW10.1, U1.32 (PC7)
GAMEPAD_SELECT: J7.3 (SCK), SW12.1, U1.9 (PB1)
GAMEPAD_START: SW11.1, U1.28 (PB4)
GAMEPAD_X: SW7.1, U1.20 (PD2)
GAMEPAD_Y: SW8.1, U1.21 (PD3)
GND: C1.2, C2.2, C3.2, C4.2, C5.2, C6.2, H1.1, H2.1, J1.6 (GND), J1.9 (GND), J1.14 (GND), J1.20 (GND), J1.25 (GND), J1.30 (GND), J1.34 (GND), J1.39 (GND), J2.2 (Gnd), J3.2 (Gnd), J4.2 (Gnd), J5.2, J6.1, J6.5, J7.6 (GND), J8.5 (GND), J8.6 (Shield), SW1.2, SW2.2, SW3.2, SW4.2, SW5.2, SW6.2, SW7.2, SW8.2, SW9.2, SW10.2, SW11.2, SW12.2, SW13.2, SW14.1, SW15.2, U1.5 (UGND), U1.15 (GND), U1.23 (GND), U1.33 (~HWB~/PE2), U1.35 (GND), U1.43 (GND), U2.2 (Gnd)
I2S_BCLK: J1.12 (GPIO18/PWM0), U2.6 (BCLK)
I2S_DIN: J1.40 (GPIO21/SCLK1), U2.5 (DIN)
I2S_LRCLK: J1.35 (GPIO19/MISO1), U2.7 (LRCLK)
LCD_CS: J1.24 (~CE0~/GPIO8), J2.3 (CS)
LCD_DC: J1.22 (GPIO25), J2.5 (DC)
LCD_LED: J2.8 (LED), U1.30 (PB6)
LCD_MISO: J1.21 (MISO0/GPIO9), J2.9 (SDO(MISO))
LCD_MOSI: J1.19 (MOSI0/GPIO10), J2.6 (SDI(MOSI))
LCD_RESET: J1.13 (GPIO27), J2.4 (RESET)
LCD_SCK: J1.23 (SCLK0/GPIO11), J2.7 (SCK)
L_JOYSTICK_BTN: J4.3 (Button), U1.8 (PB0)
L_JOYSTICK_X: J4.1 (X_Axis), U1.37 (PF6)
L_JOYSTICK_Y: J4.4 (Y_Axis), U1.36 (PF7)
MACRO_BTN: SW15.1, U1.40 (PF1)
MCU_MISO: J7.1 (MISO), U1.11 (PB3)
MCU_MOSI: J7.4 (MOSI), U1.10 (PB2)
MCU_RST: J7.5 (~RST), R1.2, U1.13 (~RESET)
unnamed: C1.1, U1.17 (XTAL1), Y1.1
unnamed: C2.1, U1.16 (XTAL2), Y1.2
unnamed: C3.1, U1.42 (AREF)
unnamed: C4.1, U1.6 (UCAP)
unnamed: SW14.2, U2.3 (SD_MODE)
R_JOYSTICK_BTN: J3.3 (Button), U1.41 (PF0)
R_JOYSTICK_X: J3.1 (X_Axis), U1.39 (PF4)
R_JOYSTICK_Y: J3.4 (Y_Axis), U1.38 (PF5)
UART_RX: J1.10 (GPIO15/RXD), J6.4
UART_TX: J1.8 (GPIO14/TXD), J6.2
USB_D+: J8.3 (D+), U1.4 (D+)
USB_D-: J8.2 (D-), U1.3 (D-)
