furrysalamander/Pi-A3-Game-Console/(commit log)

2020-10-05 bring repository up to date
    [Pi-A3-Game-Console.dsn, Pi-A3-Game-Console.kicad_pcb]
2020-10-09 Added the prototype 32u4 code. Also PCB tweaks.
    Mostly stuff related to mounting holes, though I've played around with the layout and a couple connections. Overall I'm pretty happy with everything, feel like it's getting pretty close.
    [4-LCD-Rough-v2.step, Battery Shield.step, LCD_Rough.dxf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]
2020-10-15 bring repository up to speed again
    [Pi-A3-Game-Console.kicad_pcb, Pi-A3-Game-Console.sch]
2020-10-16 update controller firmware
    [Pi-A3-Game-Console.dsn, Pi-A3-Game-Console.kicad_pcb, Pi-A3-Game-Console.sch]
2020-12-11 Update Repo to Latest Version
    [Pi-A3-Game-Console-B_Cu.gbr, Pi-A3-Game-Console-B_Mask.gbr, Pi-A3-Game-Console-B_Paste.gbr, Pi-A3-Game-Console-B_SilkS.gbr, Pi-A3-Game-Console-Edge_Cuts.gbr, Pi-A3-Game-Console-F_Cu.gbr, Pi-A3-Game-Console-F_Mask.gbr, Pi-A3-Game-Console-F_Paste.gbr]
2021-10-13 STL files for the case
    [Battery Panel.stl, Button.stl, Front Panel.stl, Rear Panel.stl, Shoulder Button.stl, Small Button.stl, dpad.stl]
